konkotgit/VSpider/photos/vspider_02.jpg

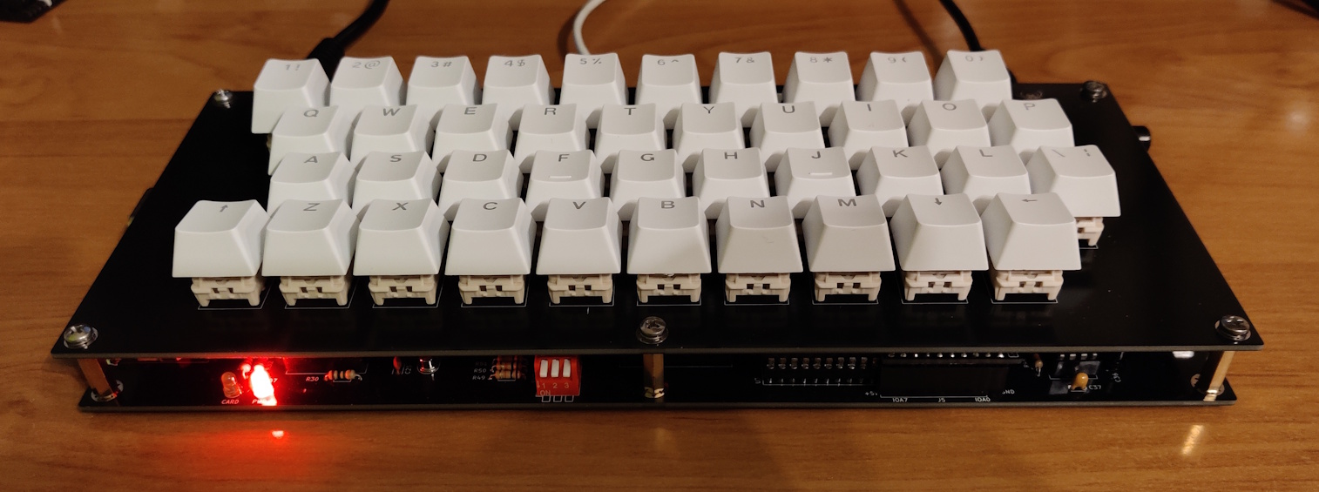
photos/vspider_02.jpg
