konkotgit/VSpider/photos/vspider_03.jpg

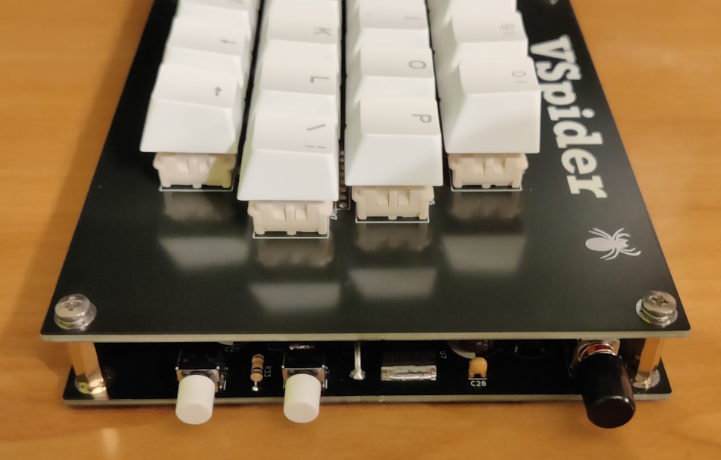
photos/vspider_03.jpg
