konkotgit/VSpider/photos/vspider_04.jpg

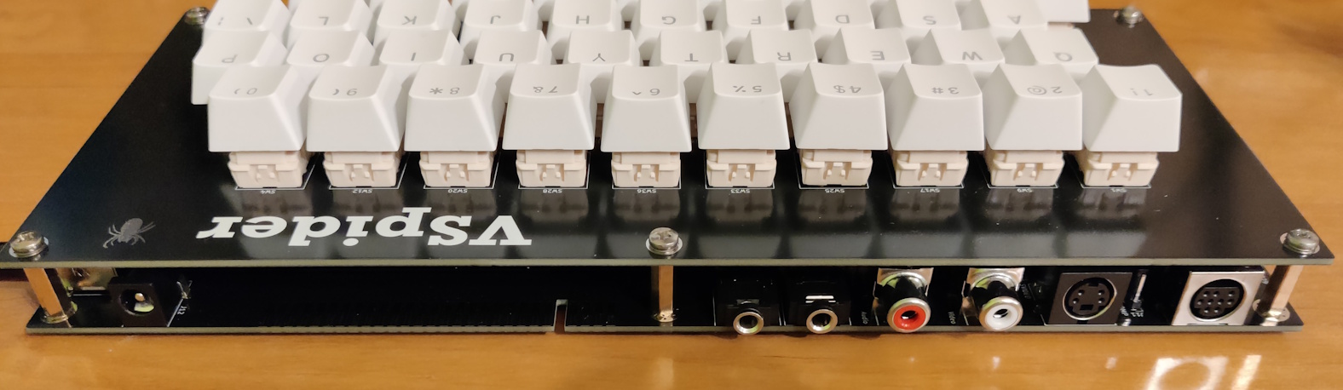
photos/vspider_04.jpg
