konkotgit/VSpider/photos/vspider_05.jpg

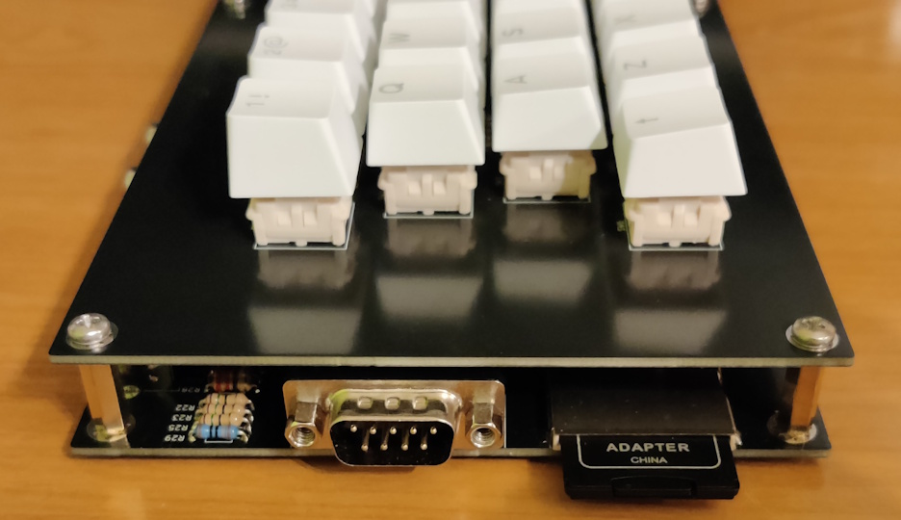
photos/vspider_05.jpg
