konkotgit/VSpider/doc/vspider_rev_1_2_schematic.pdf

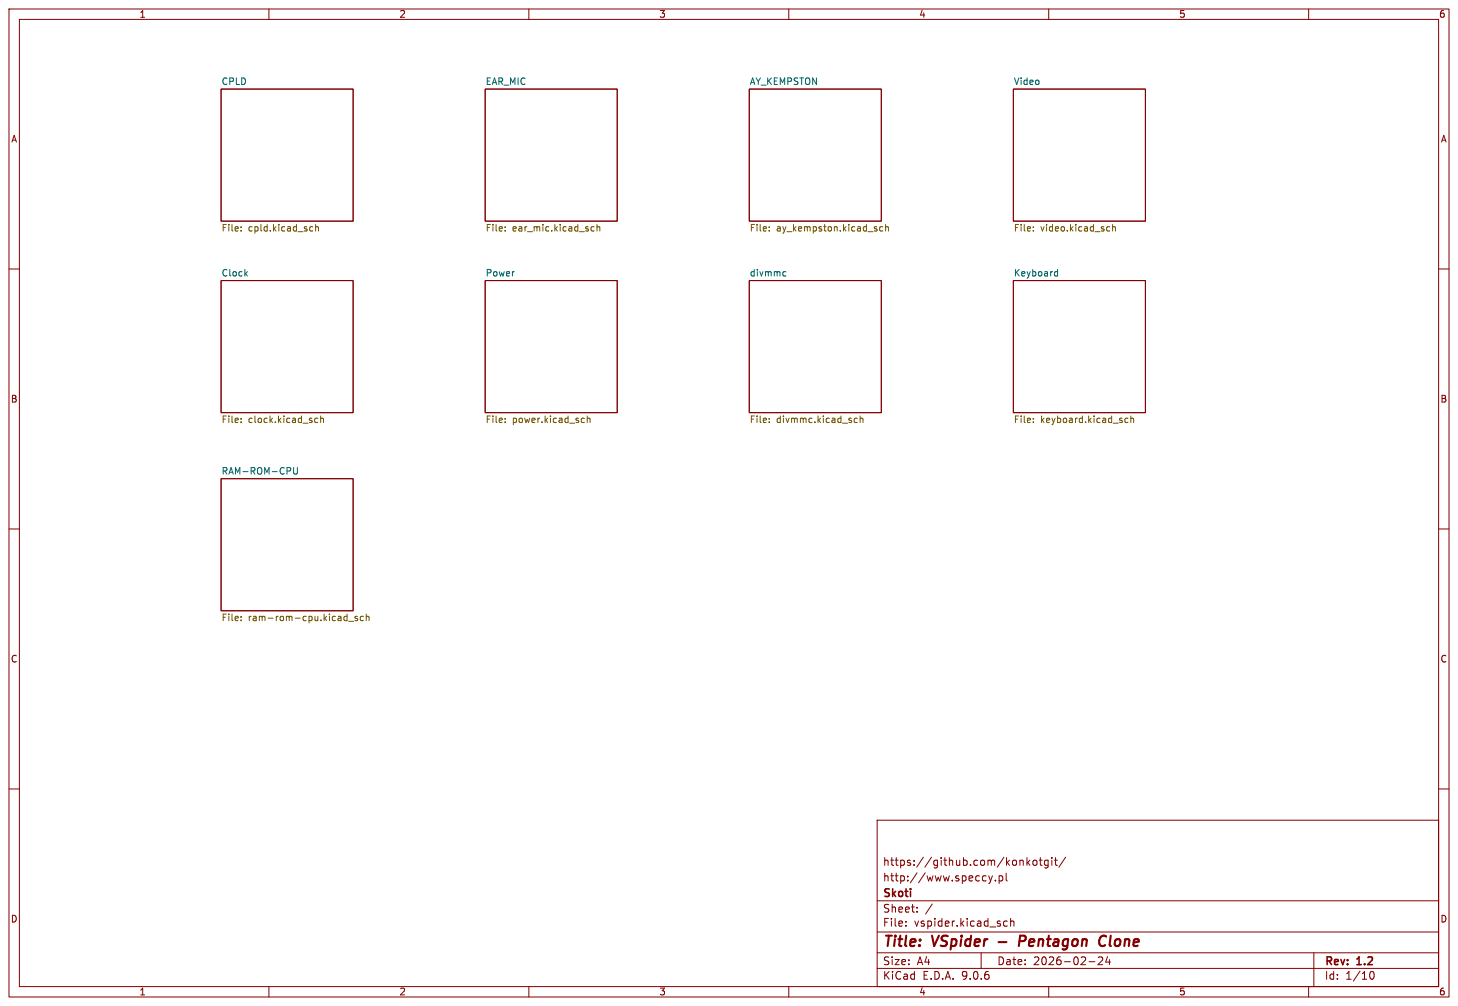
[picture p7: page 1]

divmmc File: divmmc.kicad_sch Clock File: clock.kicad_sch RAM-ROM-CPU

File: ram-rom-cpu.kicad_sch

https://github.com/konkotgit/
File: vspider.kicad_sch Sheet: / Skoti http://www.speccy.pl

Id: 1/10 Title: VSpider - Pentagon Clone

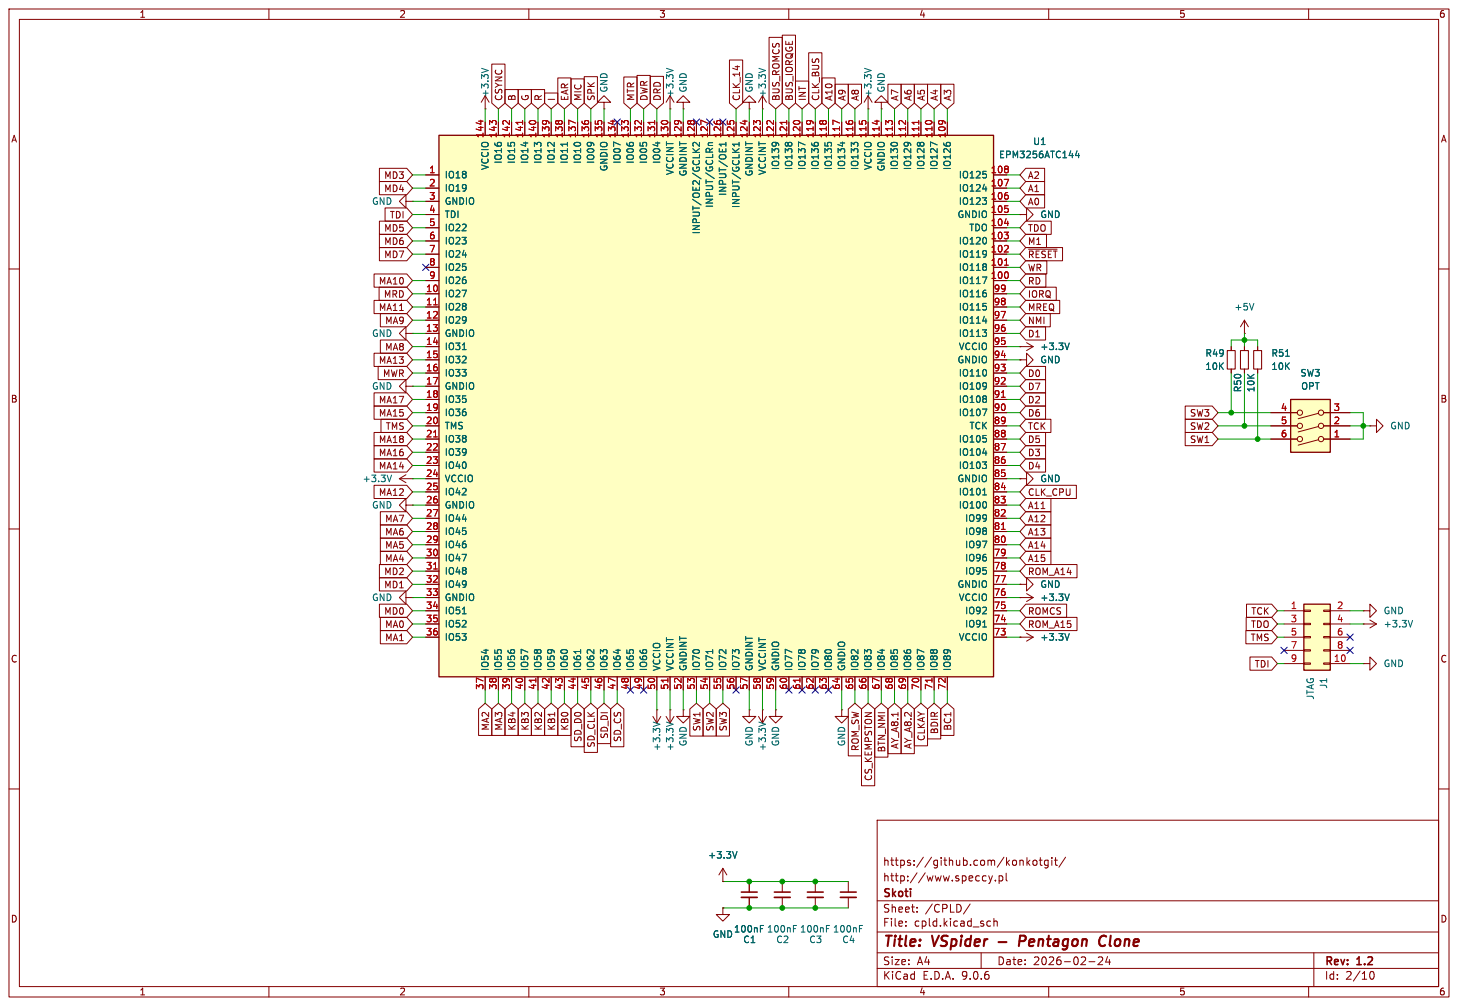
[picture p8: page 2]

https://github.com/konkotgit/ C2

File: cpld.kicad_sch Sheet: /CPLD/ Skoti http://www.speccy.pl

Id: 2/10 Title: VSpider - Pentagon Clone

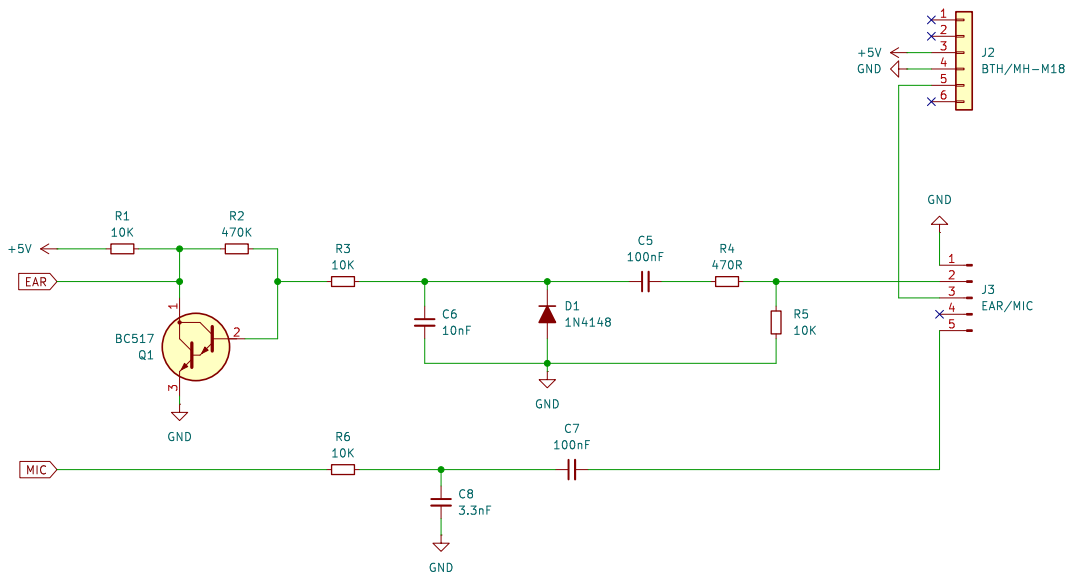
[picture p9: page 3]

https://github.com/konkotgit/
File: ear_mic.kicad_sch Sheet: /EAR_MIC/ Skoti http://www.speccy.pl

Id: 3/10 Title: VSpider - Pentagon Clone

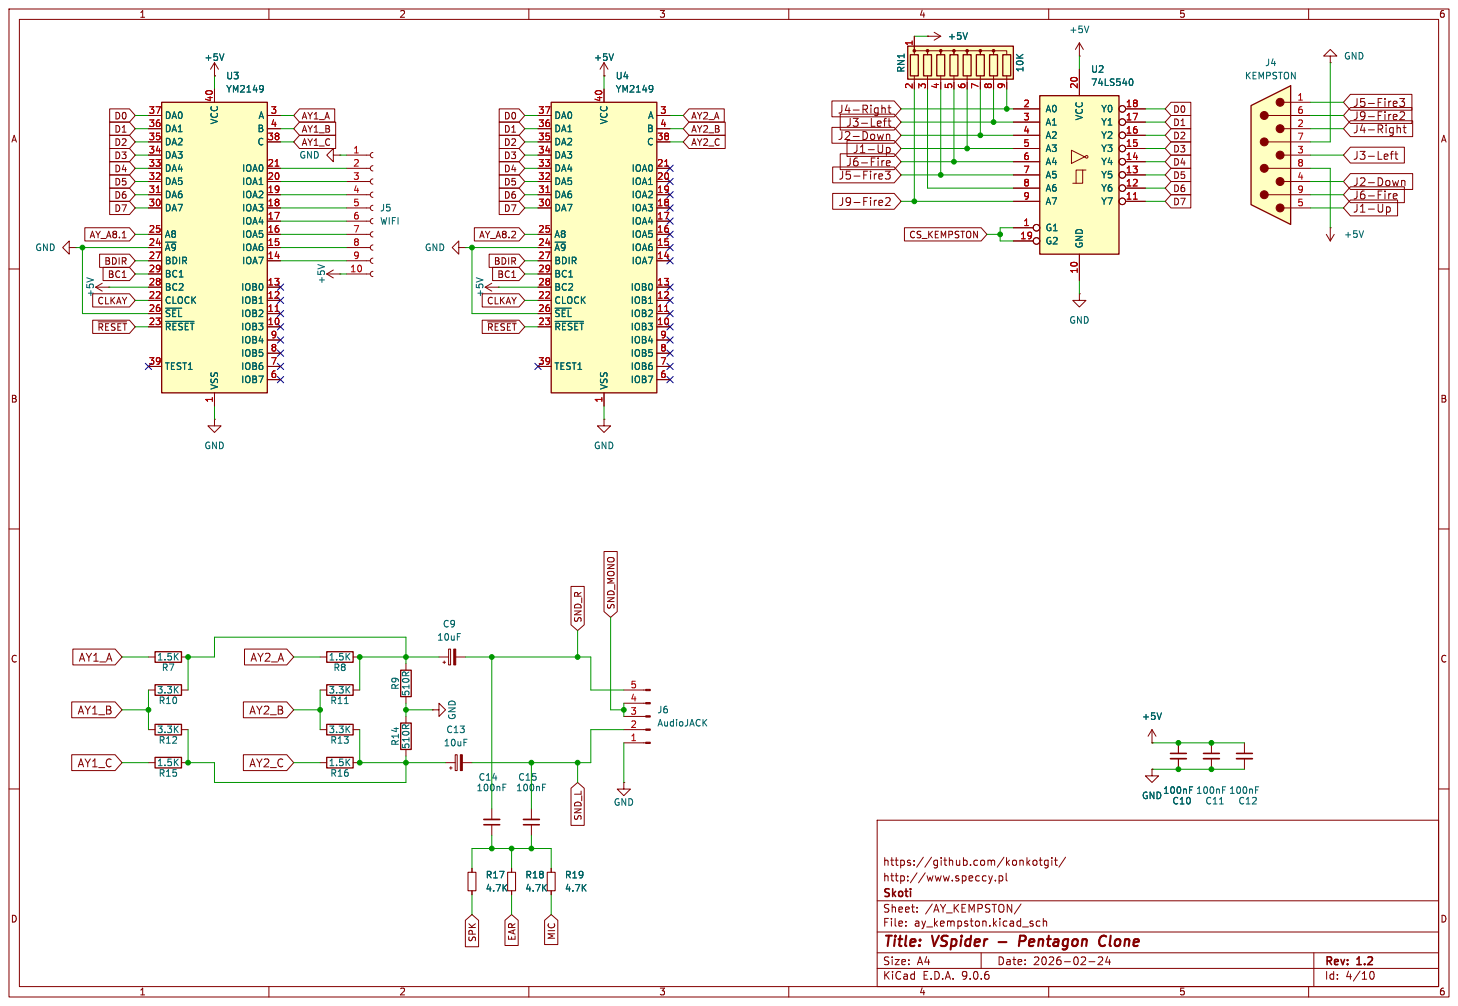
[picture p10: page 4]

https://github.com/konkotgit/
File: ay_kempston.kicad_sch Sheet: /AY_KEMPSTON/ Skoti http://www.speccy.pl

Id: 4/10 Title: VSpider - Pentagon Clone

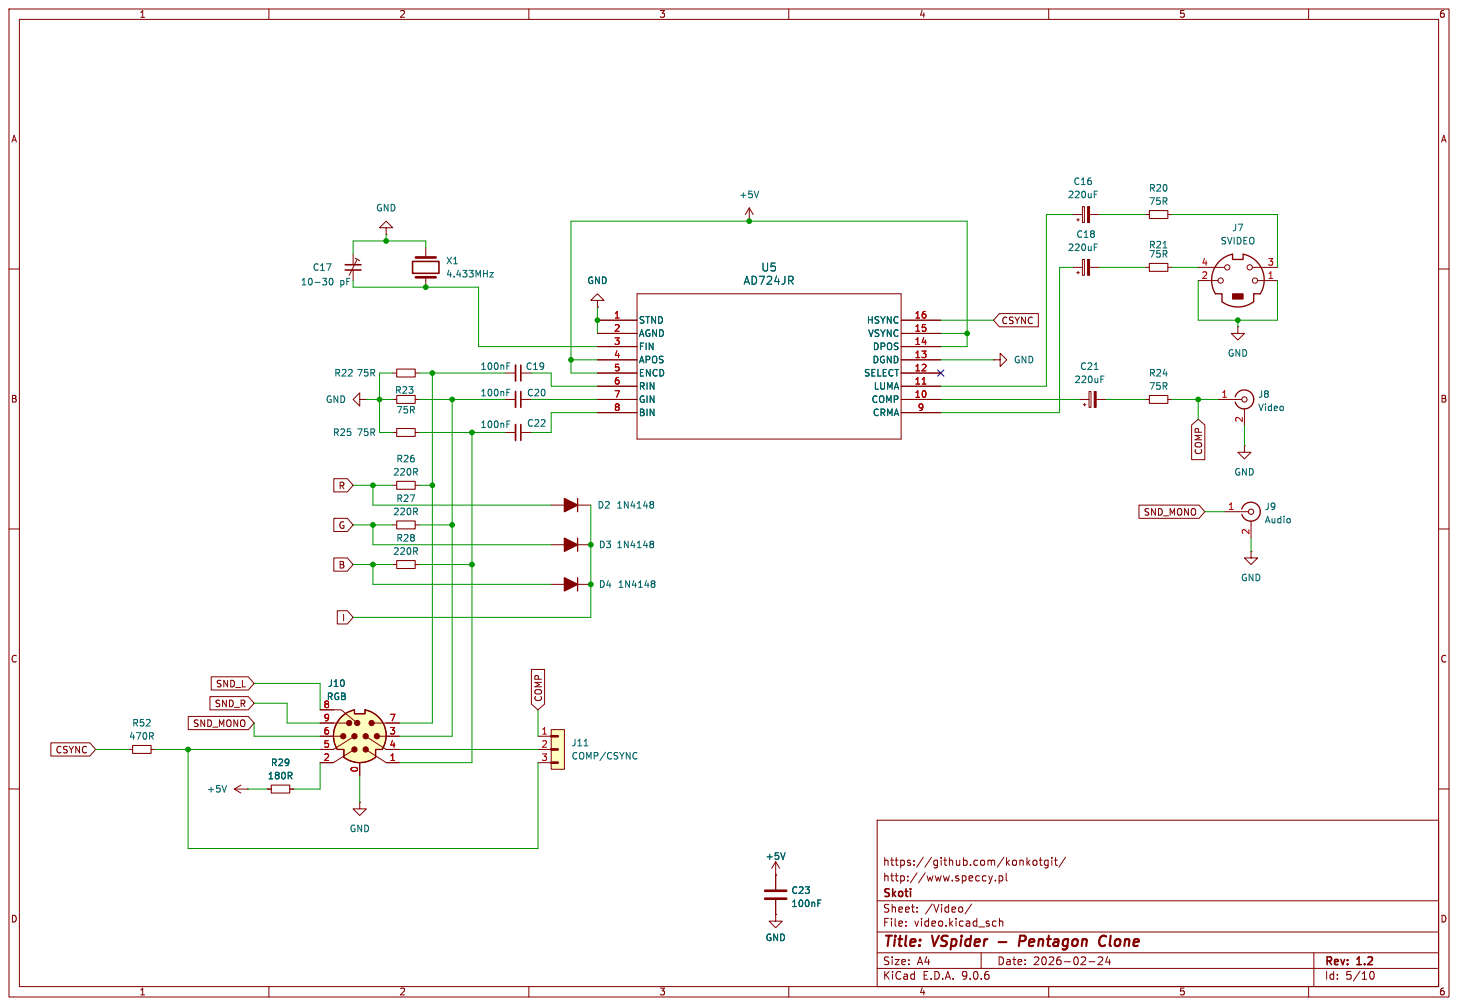
[picture p11: page 5]

https://github.com/konkotgit/
File: video.kicad_sch Sheet: /Video/ Skoti http://www.speccy.pl

Id: 5/10 Title: VSpider - Pentagon Clone

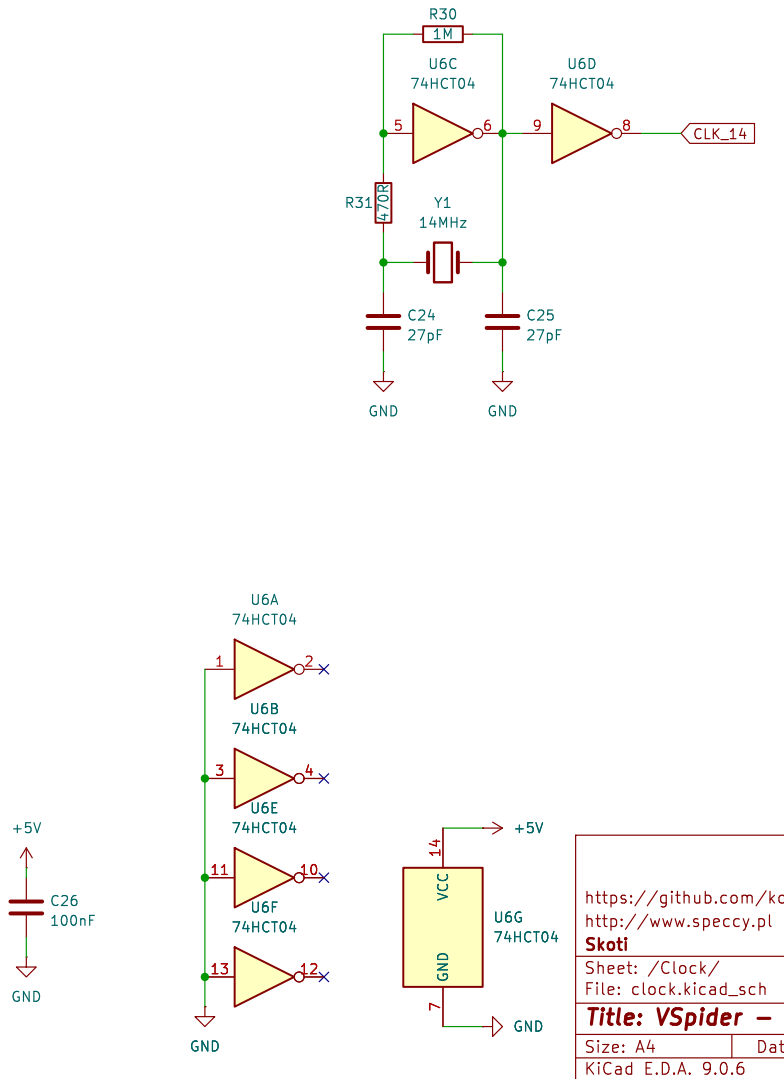
[picture p12: page 6]

File: clock.kicad_sch Sheet: /Clock/ Skoti http://www.speccy.pl

Id: 6/10 Title: VSpider - Pentagon Clone

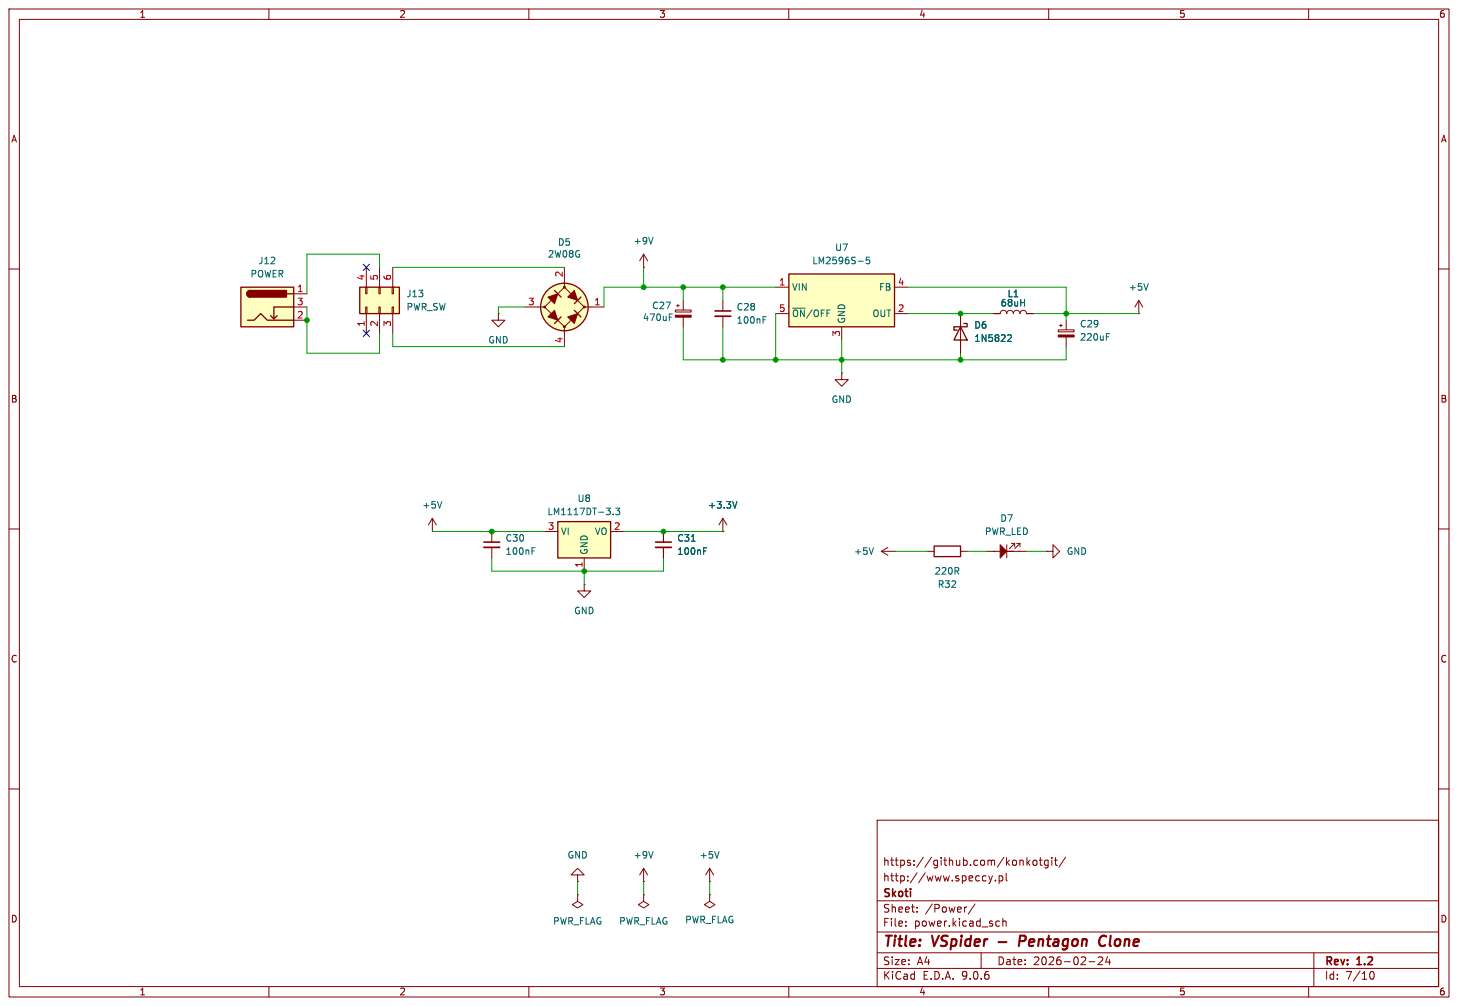
[picture p13: page 7]

https://github.com/konkotgit/
File: power.kicad_sch Sheet: /Power/ Skoti http://www.speccy.pl

Id: 7/10 Title: VSpider - Pentagon Clone

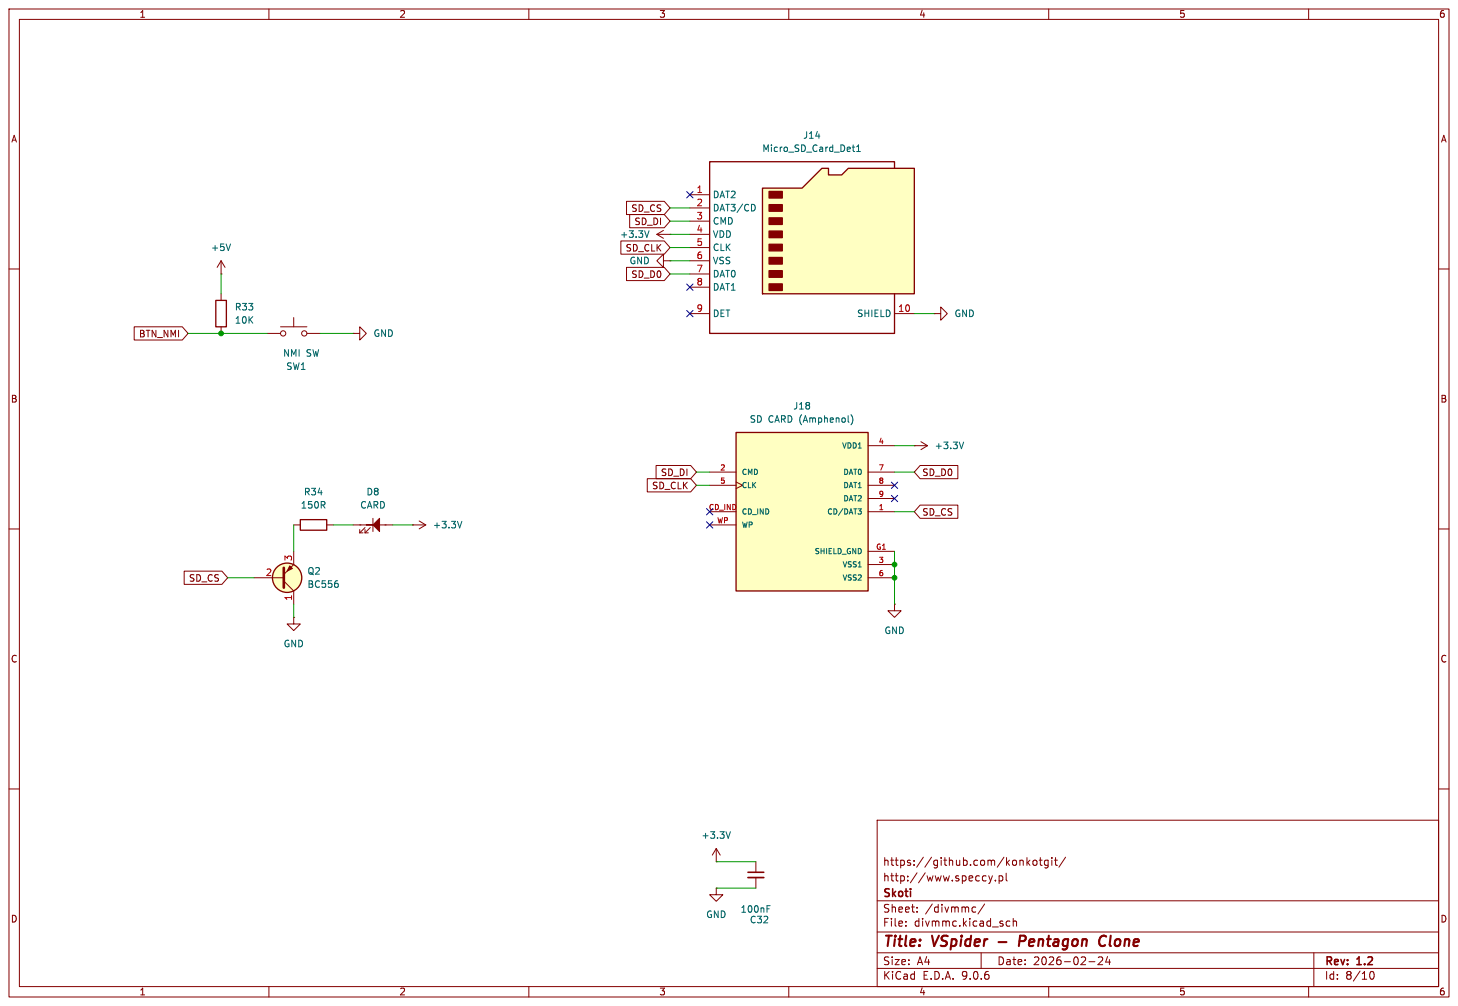
[picture p14: page 8]

https://github.com/konkotgit/
File: divmmc.kicad_sch Sheet: /divmmc/ Skoti http://www.speccy.pl

Id: 8/10 Title: VSpider - Pentagon Clone

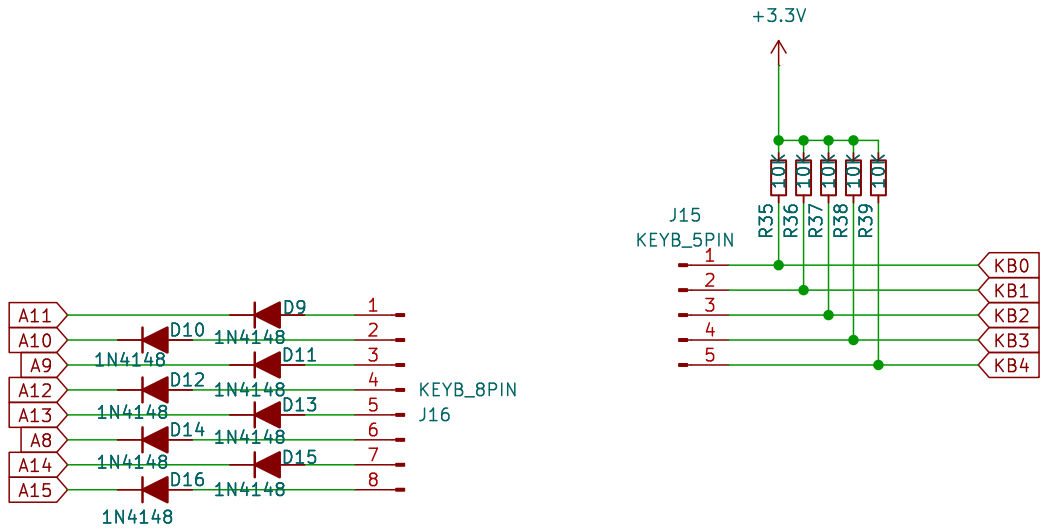
[picture p15: page 9]

https://github.com/konkotgit/
File: keyboard.kicad_sch Sheet: /Keyboard/ Skoti http://www.speccy.pl

Id: 9/10 Title: VSpider - Pentagon Clone

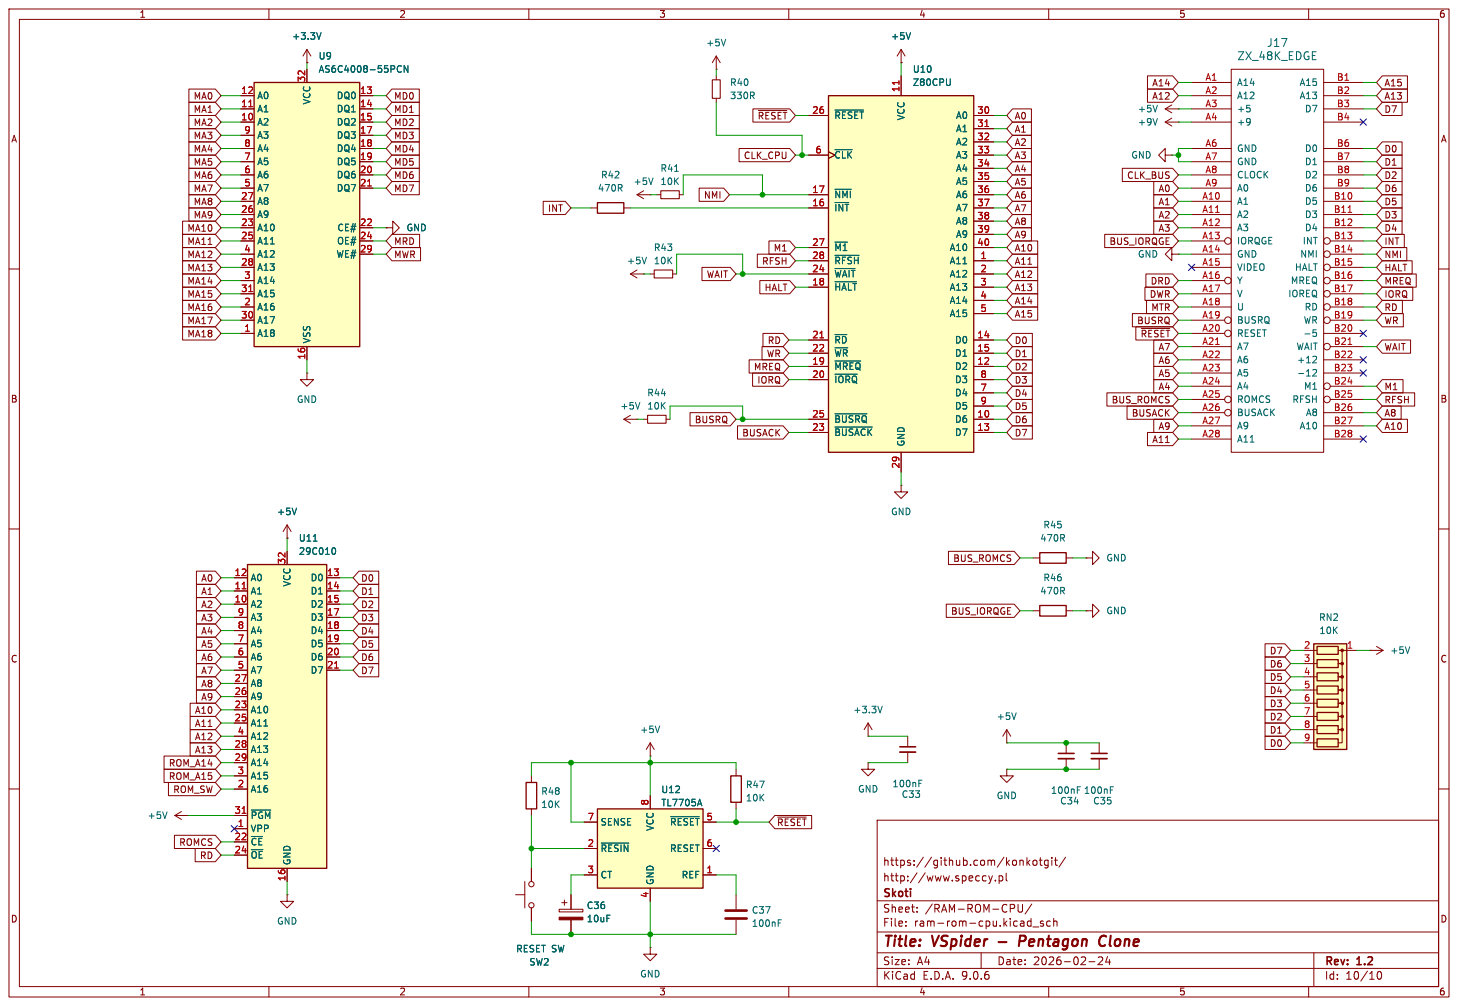
[picture p16: page 10]

https://github.com/konkotgit/ GND

File: ram-rom-cpu.kicad_sch Sheet: /RAM-ROM-CPU/ Skoti http://www.speccy.pl

Id: 10/10 Title: VSpider - Pentagon Clone
