konkotgit/VSpider/(commit log)

2026-03-08 Gerber files
    Gerber files
2026-03-15 BOM Update
    R26 R27 R28 change value from 220R to 150R
2026-05-16 Release universal firmware for VSpider
    Release of universal VSpider firmware and ROM based on Andy Karpov’s work
